tejasnat/LAM-FiniteElementGang/LRC_26_0388_Finite_Element_Gang_Stage_2.pdf

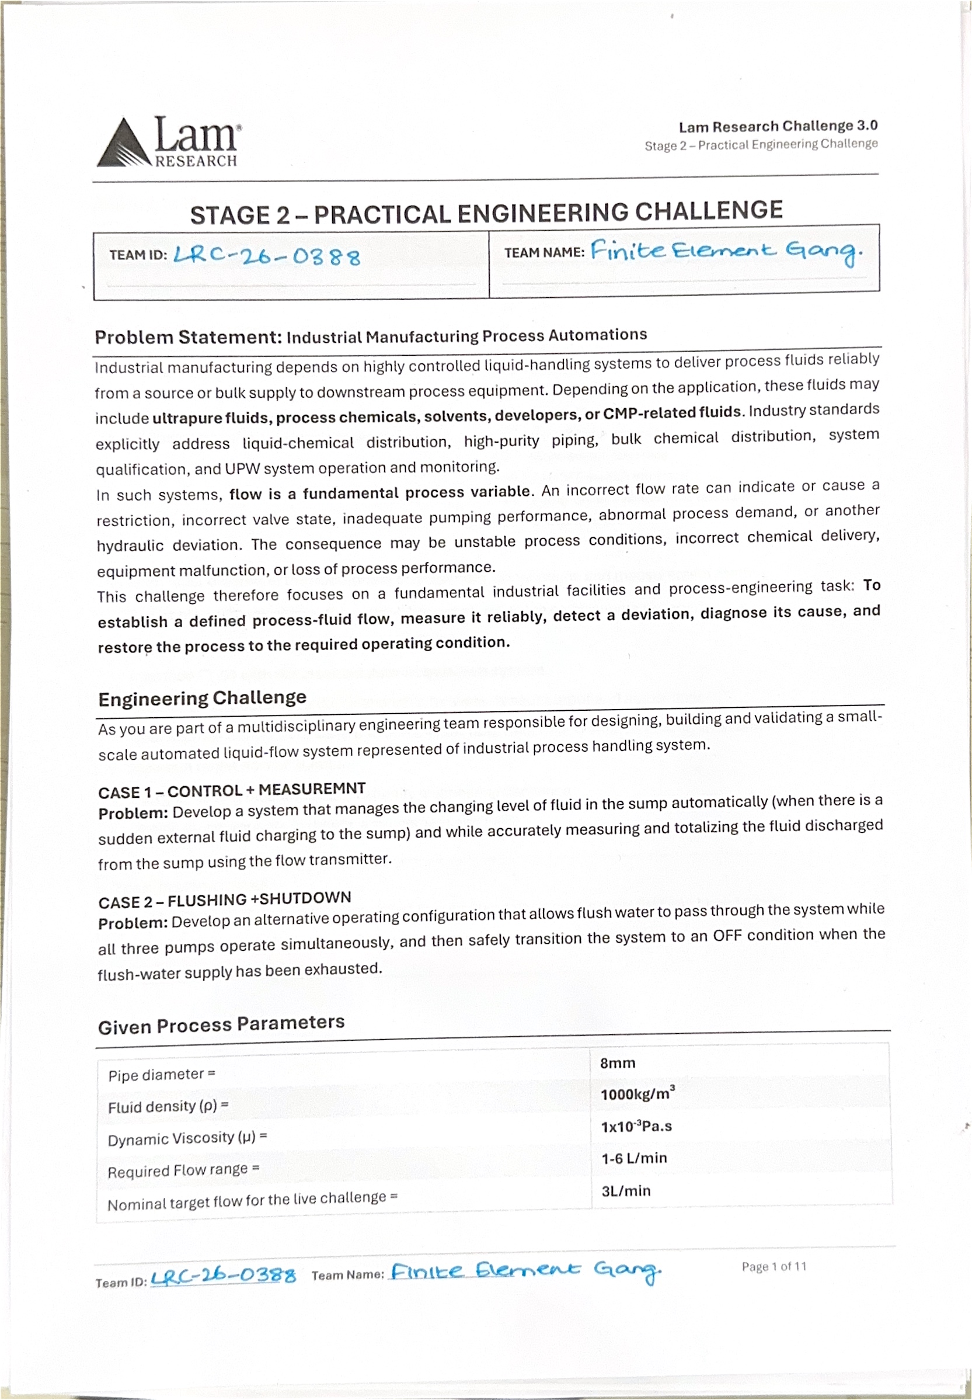
[picture p1: page 1]
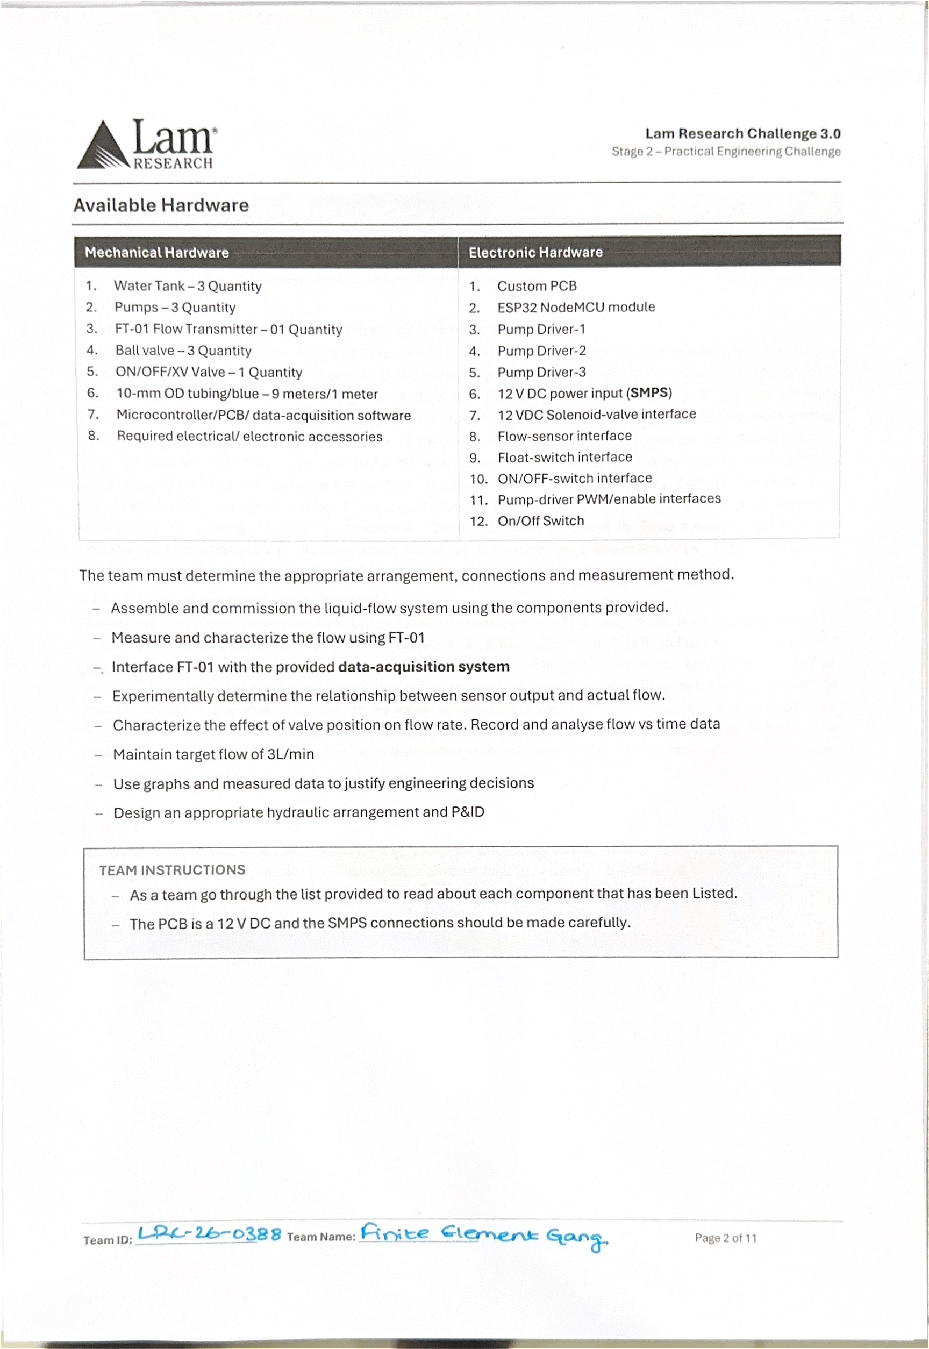
[picture p2: page 2]
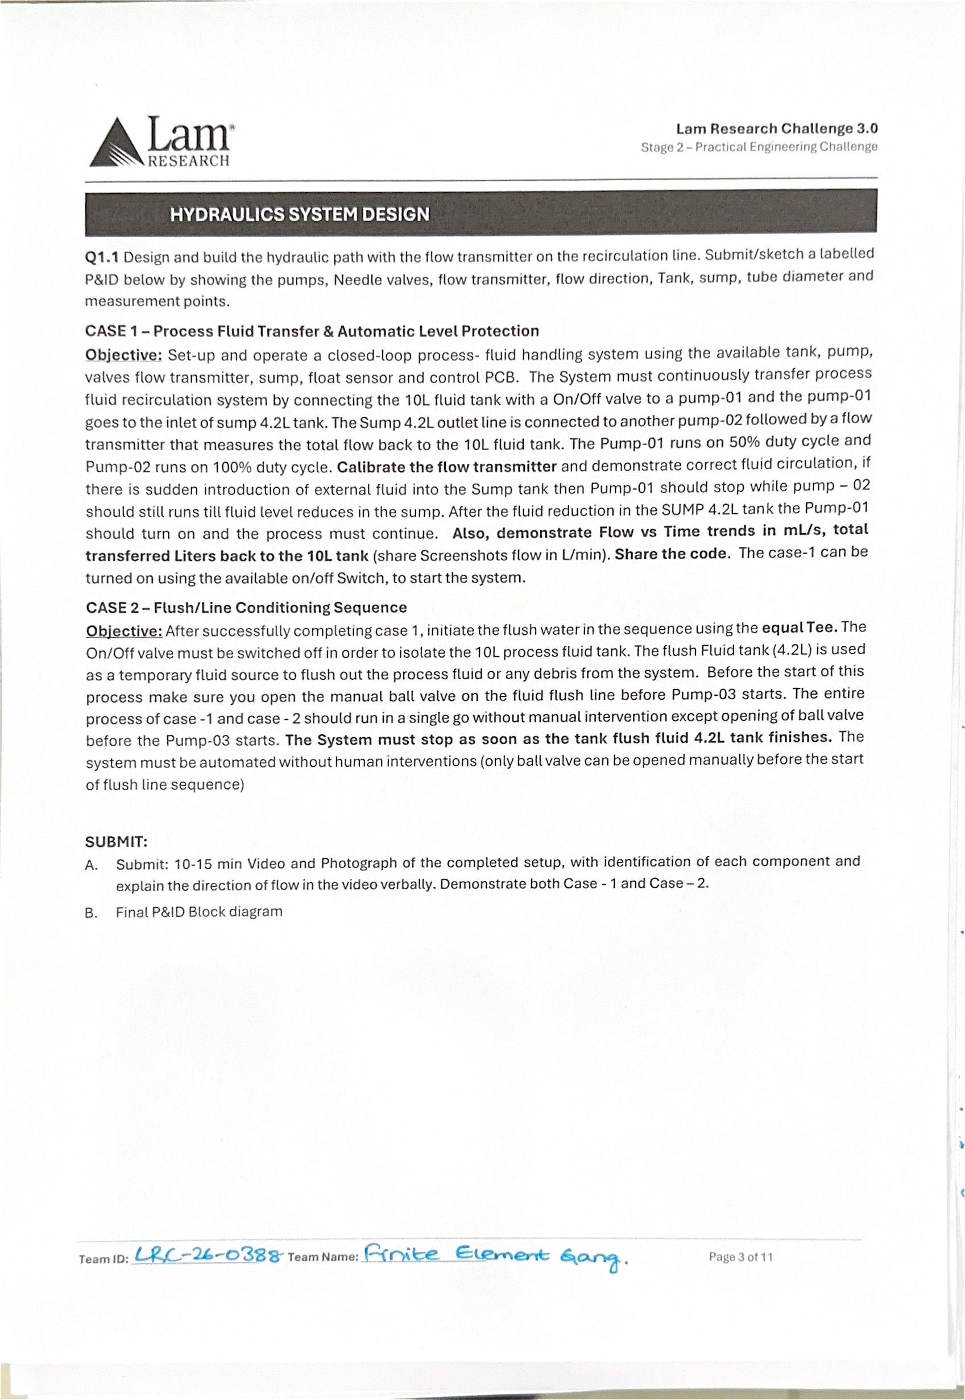
[picture p3: page 3]
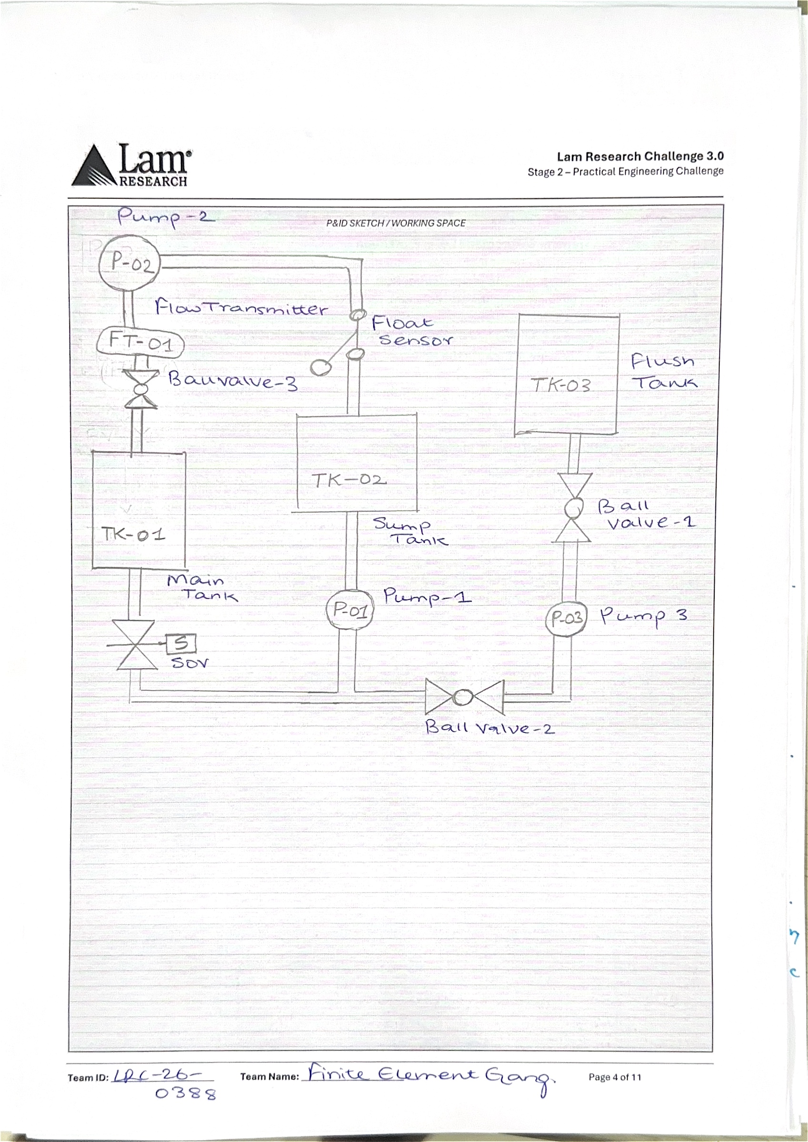
[picture p4: page 4]
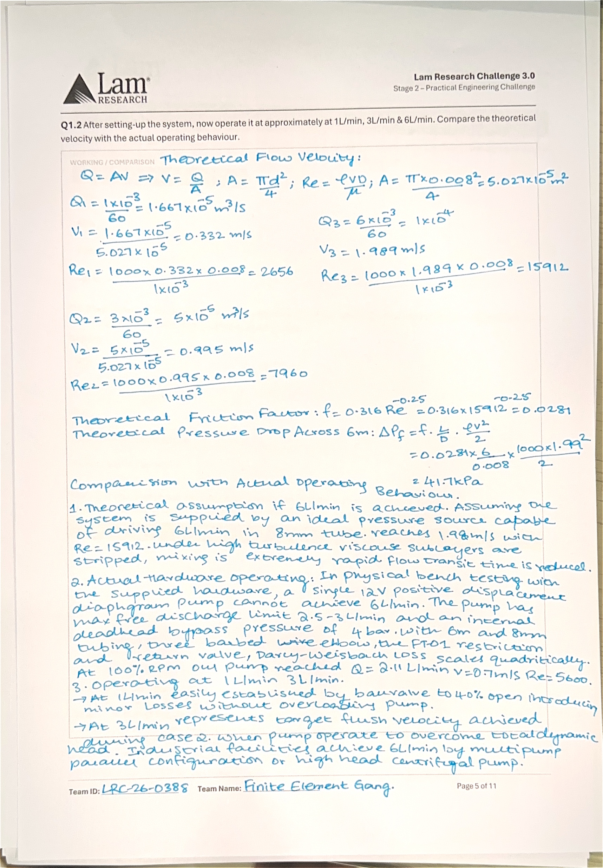
[picture p5: page 5]
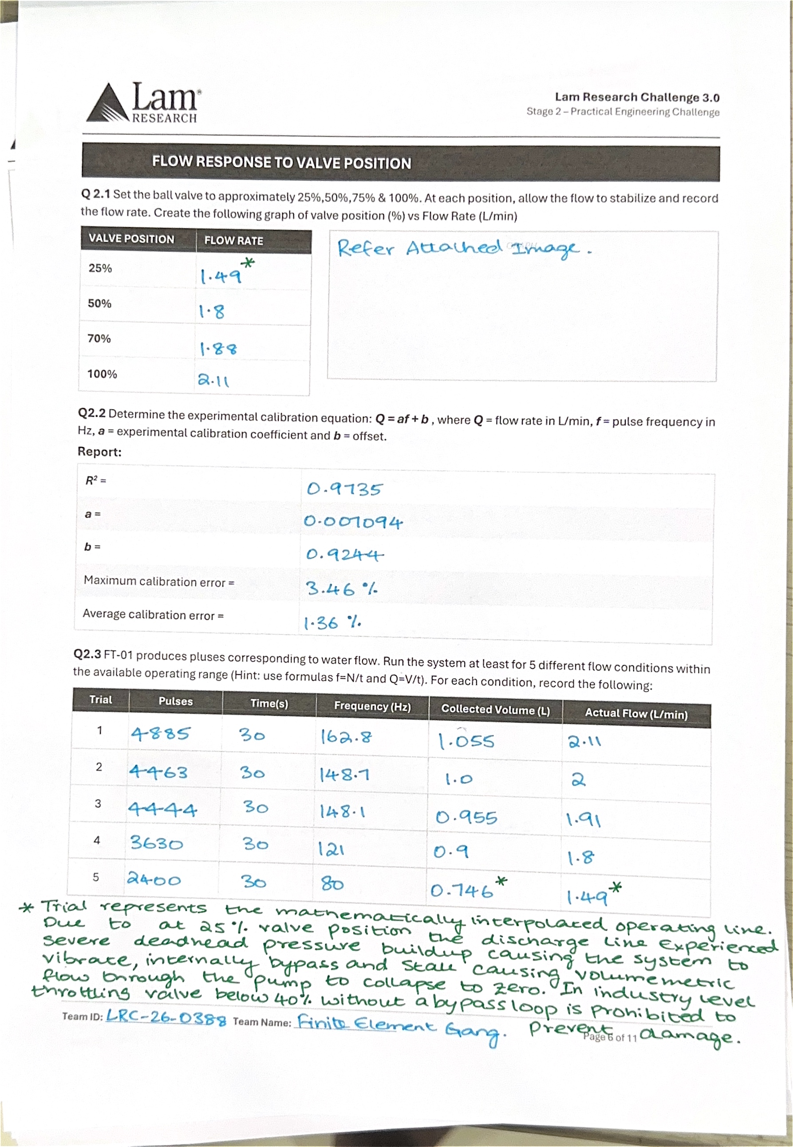
[picture p6: page 6]
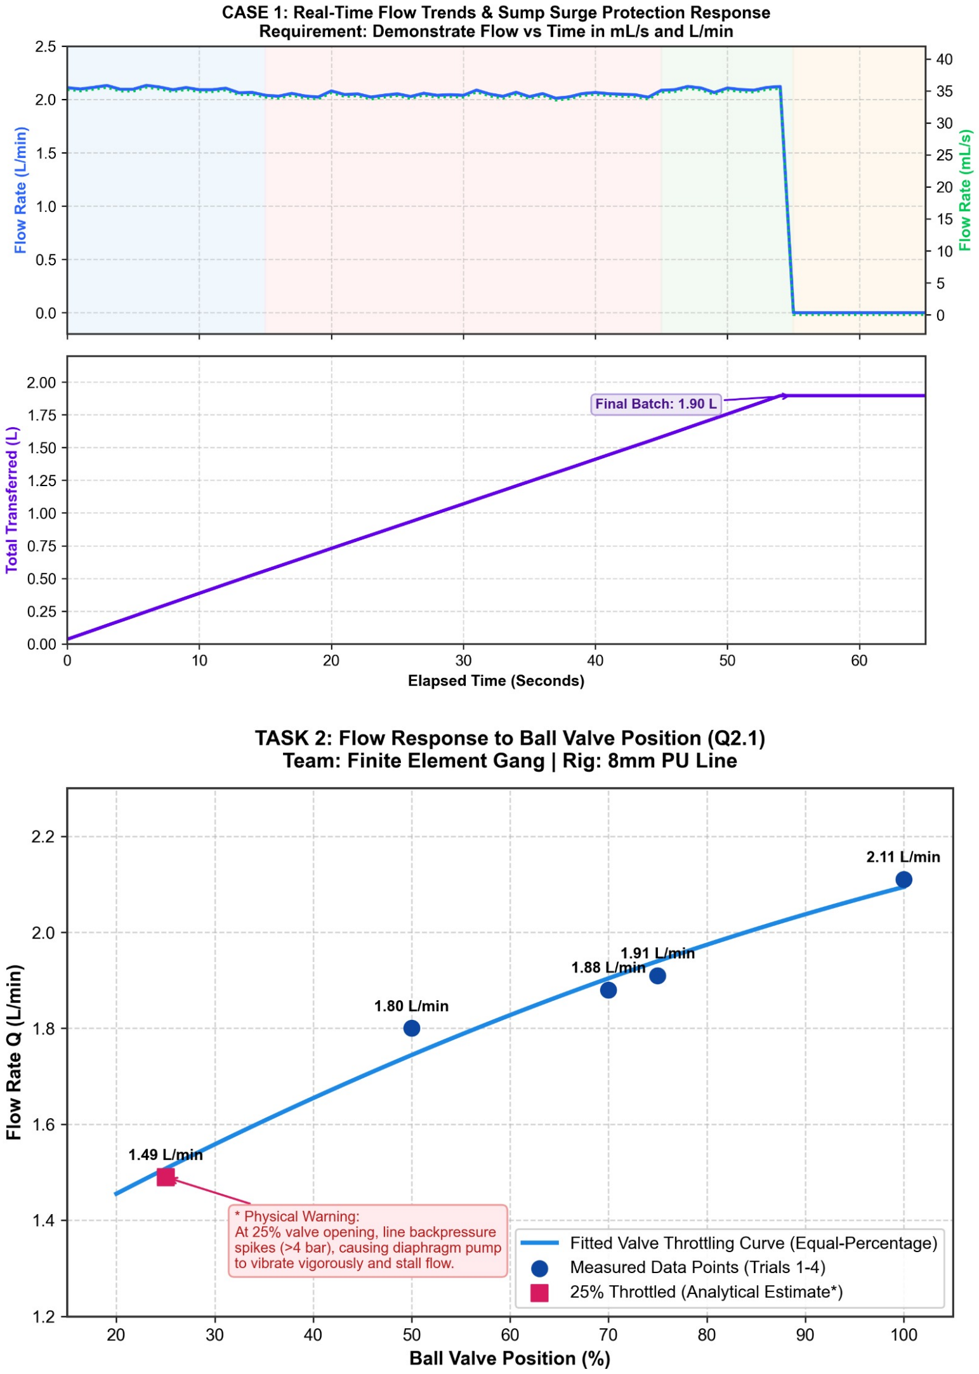
[picture p7: page 7]
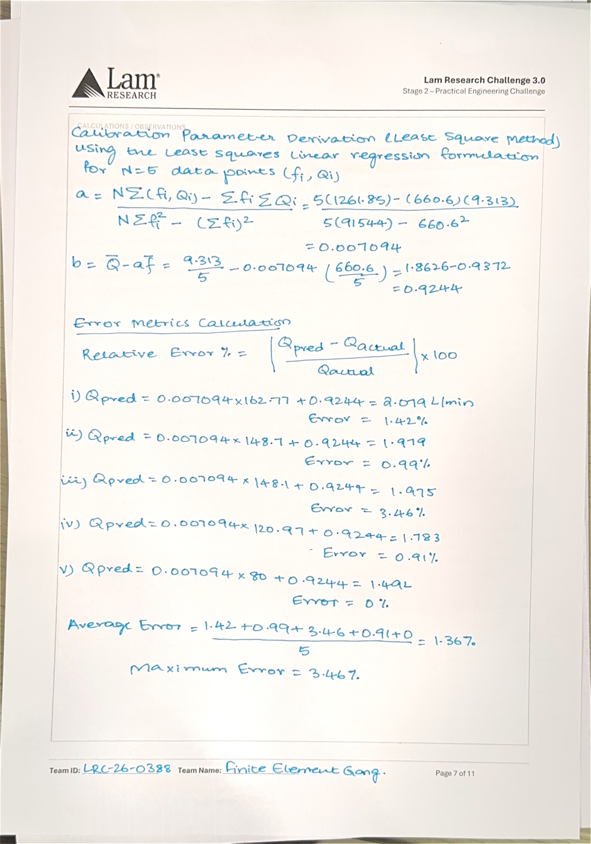
[picture p8: page 8]

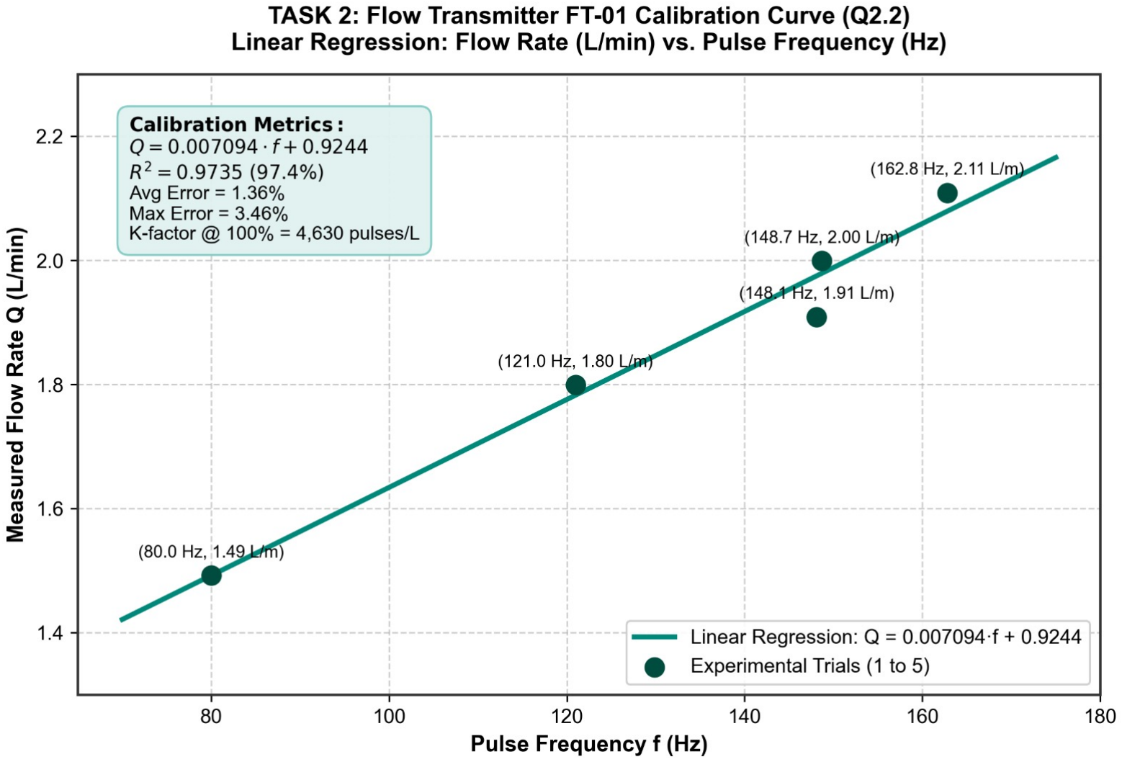
[picture p9: figure]
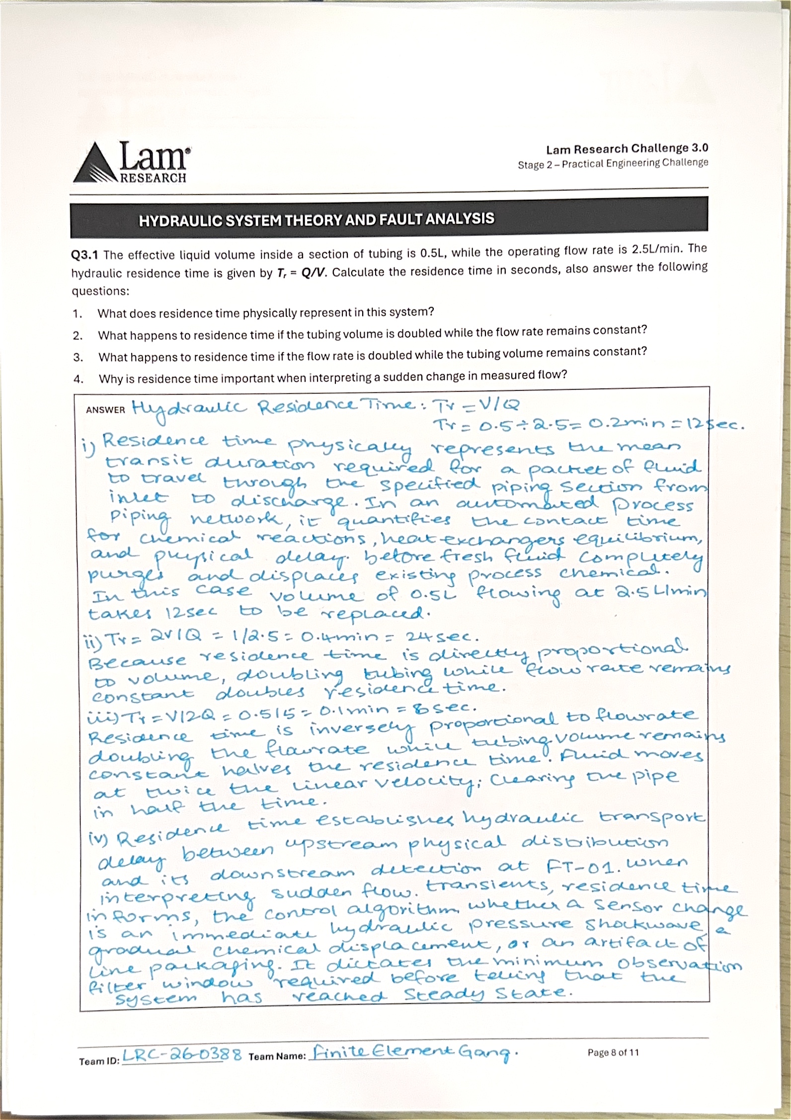
[picture p10: page 10]
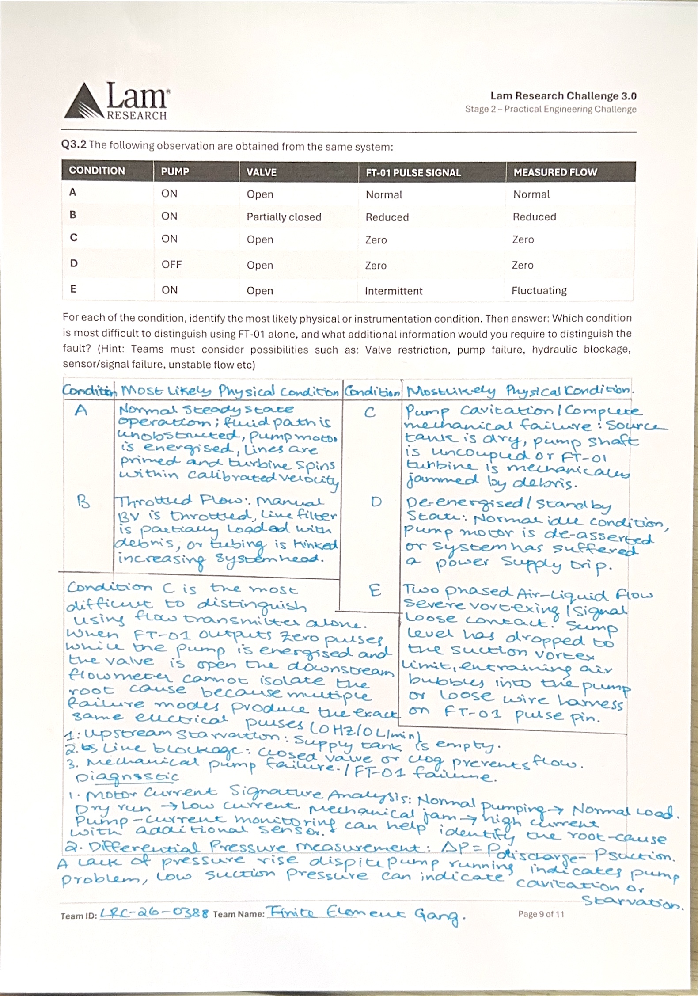
[picture p11: page 11]

/*
*
========================================================================= ===
* Lam Research Challenge 3.0 - Stage 2: Master Dual-Case Automation
* Team: Finite Element Gang
*
========================================================================= ===
* EXECUTION SEQUENCE:
* 1. Case 1 starts with physical Push Button (or 's'). Solenoid OPENS, P1=50%, P2=100%, P3=OFF.
* | 2. Sump Surge Test:
* | - Water tilts float UP (GPIO 35 = LOW).
* | - Pump-01 instantly trips to OFF (0%) and is LOCKED OFF for 30
SECONDS.
* | - Pump-02 drains the sump alone at 100% PWM for the full 30
seconds.
* | 3. Case 1 Resumption (10 Seconds):
* | - After 30s drain, Pump-01 restarts at 50% PWM, Pump-02 stays
at 100%
* | for 10 seconds to prove stable recirculation recovery on
camera.
* | 4. 15-Second Transition Countdown:
* | - Solenoid CLOSES immediately (10L tank isolated). Pumps pause.
* | - Live countdown in Serial Monitor: Operator opens manual valve
BV-03.
* | 5. Case 2 Flush:
* | - All 3 pumps fire at 100% simultaneously.
* | 6. Flush Tank Cutoff (Industrial Batch Totalizer):
* | - Totalizes flushed volume using FT-01 up to 2.50 Liters.
* | - When 2.50L is reached (or early dry-out < 60 Hz), all 3 pumps
* | safely shut down to OFF (0%). Zero human touch.
*
========================================================================= ===
*/

#include <Arduino.h>

// ---------------- HARDWARE PIN ALLOCATIONS ----------------
const int PIN_FLOW_SENSOR | = 14; | // FT-01 Pulse Interrupt
const int PIN_FLOAT_SWITCH = 35; | // LS-01 Sump Float Switch (GPIO 35)
const int PIN_START_BUTTON = 34; | // SW-01 Hardware Push Button (GPIO 34
- ON/OFF_SWITCH header)
const int PIN_SOLENOID | = 27; | // OV-01 Solenoid via D4184 MOSFET

// Motor Driver U2 (Pump-01: Process Feed)
const int PIN_P1_LPWM = 32;
const int PIN_P1_LEN | = 13;
const int PIN_P1_REN | = 26;

// Motor Driver U3 (Pump-02: Recirculation Return) const int PIN_P2_LPWM = 18;
const int PIN_P2_LEN | = 16; | // GPIO 16 (L_EN2)
const int PIN_P2_REN | = 17; | // GPIO 17 (R_EN2)

// Motor Driver U4 (Pump-03: Flush Supply)

const int PIN_P3_LPWM = 23;
const int PIN_P3_LEN | = 21;
const int PIN_P3_REN | = 22;

// ---------------- PWM SETTINGS (ESP32 Core 3.0+) ----------------const int PWM_FREQ = 5000;
const int PWM_RES | = 8; // 8-bit: 0 to 255
const int DUTY_50_PCT | = 128; // 50% PWM Duty Cycle
const int DUTY_100_PCT = 255; // 100% PWM Duty Cycle

// ---------------- FLOW CALIBRATION CONSTANTS (Task 2: Q = a*f + b) ----------------
// Values derived from 5-point experimental recalibration (R^2 = 0.9735, Avg Error = 1.36%):
float cal_a = 0.007094; // Experimental slope
float cal_b = 0.924388; // Experimental offset
const float PULSES_PER_LITER = 4630.0; // Measured pulses per liter at 100% flow

// ---------------- USER CONFIGURABLE THRESHOLDS ----------------
const unsigned long SURGE_STARTUP_IMMUNITY_MS = 3000; // 3s grace on startup before surge can trip
const unsigned long FLOAT_DEBOUNCE_MS | = 500; | // Float must stay
LOW continuously for 500ms
const unsigned long SURGE_DRAIN_TIME_MS | = 30000; // Fixed 30
seconds drain with Pump-01 locked OFF
const unsigned long RESUME_RUN_TIME_MS | = 10000; // 10 seconds
normal Case 1 recovery before Case 2
const unsigned long TRANSITION_TIME_MS | = 15000; // 15 seconds to
open BV-03

// Case 2 Flush Batch Totalizer & Safety Cutoff:
const float | FLUSH_BATCH_TARGET_L | = 2.50; | // Batch totalizer
target: exactly 2.50 Liters
const unsigned long FLUSH_INITIAL_GRACE_MS | = 6000; | // 6s window to
allow lines to fill & prime
const float | FLUSH_ESTABLISHED_FREQ_HZ = 100.0; // Flow considered
established when > 100 Hz (rig runs ~128 Hz)
const float | FLUSH_DRY_CUTOFF_FREQ_HZ | = 60.0; | // Flow collapsing
below 60 Hz means loss of liquid
const int | FLUSH_CUTOFF_CONSECUTIVE_SEC = 2; | // for 2
consecutive seconds

// ---------------- STATE MACHINE STATES ----------------enum SystemState {
STATE_STANDBY,
STATE_CASE1_RECIRC,
STATE_CASE1_SURGE_DRAINING, STATE_CASE1_RESUMED,
STATE_TRANSITION,
STATE_CASE2_FLUSHING,
STATE_SYSTEM_SHUTDOWN
};

SystemState currentState = STATE_STANDBY;

// ---------------- RUNTIME VARIABLES ----------------volatile unsigned long pulseCount = 0; unsigned long prevPulses = 0; unsigned long lastTelemetryTime = 0;

unsigned long stateStartTime = 0; unsigned long surgeDrainStartTime = 0; unsigned long resumeStartTime = 0; unsigned long flushStartPulseCount = 0; unsigned long floatLowStartTime = 0; bool flushFlowEstablished = false; int lastCountdownSec = -1;
int flushDropConsecutiveSeconds = 0;

float totalTransferredLiters = 0.0; // Case 1 calibrated integrated volume (L)
float flushedVolume = 0.0; | // Case 2 calibrated integrated flush
volume (L)

// Flow Sensor Interrupt
void IRAM_ATTR flowISR() { pulseCount++;
}

void setSolenoid(bool open) { digitalWrite(PIN_SOLENOID, open ? HIGH : LOW); }

void setPumpSpeeds(int p1, int p2, int p3) { ledcWrite(PIN_P1_LPWM, p1); ledcWrite(PIN_P2_LPWM, p2); ledcWrite(PIN_P3_LPWM, p3);
}

void emergencyStop() {
currentState = STATE_SYSTEM_SHUTDOWN;
setPumpSpeeds(0, 0, 0);
setSolenoid(false);
Serial.println("\n[EMERGENCY STOP] >>> ALL ACTUATORS KILLED. SYSTEM SAFE. <<<");
Serial.println("[EMERGENCY STOP] Press Push Button or type 's' to restart in STANDBY.\n");
}

void startCase1(unsigned long now) { currentState = STATE_CASE1_RECIRC; stateStartTime = now;
floatLowStartTime = 0;
totalTransferredLiters = 0.0;
setSolenoid(true);
setPumpSpeeds(DUTY_50_PCT, DUTY_100_PCT, 0); Serial.println("\n[PHASE 1] CASE 1 STARTED: NORMAL RECIRCULATION LOOP");
Serial.println(" | - OV-01 Solenoid: OPEN");
Serial.println(" | - Pump-01: 50% PWM | Pump-02: 100% PWM | Pump-03:
OFF");
Serial.println(" - Sump surge protection armed (3s startup immunity active)...\n");
}

void setup() {
Serial.begin(115200);
delay(1000);

pinMode(PIN_SOLENOID, OUTPUT); digitalWrite(PIN_SOLENOID, LOW);

pinMode(PIN_FLOAT_SWITCH, INPUT); pinMode(PIN_START_BUTTON, INPUT);

pinMode(PIN_FLOW_SENSOR, INPUT_PULLUP); attachInterrupt(digitalPinToInterrupt(PIN_FLOW_SENSOR), flowISR, FALLING);

// Pump 1
pinMode(PIN_P1_LEN, OUTPUT); digitalWrite(PIN_P1_LEN, HIGH); pinMode(PIN_P1_REN, OUTPUT); digitalWrite(PIN_P1_REN, HIGH); ledcAttach(PIN_P1_LPWM, PWM_FREQ, PWM_RES); ledcWrite(PIN_P1_LPWM, 0);

// Pump 2
pinMode(PIN_P2_LEN, OUTPUT); digitalWrite(PIN_P2_LEN, HIGH); pinMode(PIN_P2_REN, OUTPUT); digitalWrite(PIN_P2_REN, HIGH); ledcAttach(PIN_P2_LPWM, PWM_FREQ, PWM_RES); ledcWrite(PIN_P2_LPWM, 0);

// Pump 3
pinMode(PIN_P3_LEN, OUTPUT); digitalWrite(PIN_P3_LEN, HIGH); pinMode(PIN_P3_REN, OUTPUT); digitalWrite(PIN_P3_REN, HIGH); ledcAttach(PIN_P3_LPWM, PWM_FREQ, PWM_RES); ledcWrite(PIN_P3_LPWM, 0);

Serial.println("\n======================================================= ");
Serial.println(" LAM Challenge Stage 2 - Master Dual-Case Automation ");
Serial.println(" Team: Finite Element Gang
");

Serial.println("=======================================================") ;
Serial.println("Rig initialized in STANDBY.");
int initFS = digitalRead(PIN_FLOAT_SWITCH);
Serial.printf(" -> Float Switch Pre-Check (GPIO 35): %s\n", (initFS == LOW) ? "CLOSED / UP! (Warning: Sump water is already high!)" : "OPEN / DOWN (OK - Ready for surge)");
int initBtn = digitalRead(PIN_START_BUTTON);
Serial.printf(" | -> Push Button Pre-Check (GPIO 34): | %s\n",
(initBtn == LOW) ? "DETECTED LOW (Pressed / Closed)" : "HIGH (Normal / Open - Ready to press)");
Serial.println(" -> Press PHYSICAL PUSH BUTTON (or type 's') to START CASE 1");
Serial.println(" -> Type 'x' at any time for EMERGENCY STOP");

Serial.println("=======================================================\n ");

}

void loop() {
unsigned long now = millis();

// 1. Process Hardware Push Button (GPIO 34 with 40ms digital debounce) static unsigned long btnPressStartTime = 0;
static bool btnHandled = false;

int btnVal = digitalRead(PIN_START_BUTTON); if (btnVal == LOW) {
if (btnPressStartTime == 0) {
btnPressStartTime = now;
} else if ((now - btnPressStartTime >= 40) && !btnHandled) { btnHandled = true; // Mark handled so holding button doesn't re-trigger
if (currentState == STATE_STANDBY || currentState == STATE_SYSTEM_SHUTDOWN) {
Serial.println("\n>>> [HARDWARE TRIGGER] START PUSH BUTTON PRESSED! <<<");
startCase1(now);
}
}
} else {
btnPressStartTime = 0;
btnHandled = false; // Re-arm once released
}

// 2. Process Serial Commands (Retained as fallback) if (Serial.available() > 0) {
String cmd = Serial.readStringUntil('\n');
cmd.trim();
if (cmd.equalsIgnoreCase("s") || cmd.equalsIgnoreCase("start")) { if (currentState == STATE_STANDBY || currentState == STATE_SYSTEM_SHUTDOWN) {
Serial.println("\n>>> [SERIAL TRIGGER] 's' Command Received! <<<");
startCase1(now);
}
} else if (cmd.equalsIgnoreCase("next") || cmd.equalsIgnoreCase("f")) {
if (currentState == STATE_CASE1_RECIRC || currentState == STATE_CASE1_SURGE_DRAINING || currentState == STATE_CASE1_RESUMED) { currentState = STATE_TRANSITION;
stateStartTime = now;
lastCountdownSec = -1;
setSolenoid(false);
setPumpSpeeds(0, 0, 0);
}
} else if (cmd.equalsIgnoreCase("x") || cmd.equalsIgnoreCase("stop")) {
emergencyStop();
}
}

// 2. Finite State Machine Logic switch (currentState) {
case STATE_STANDBY:

break;

case STATE_CASE1_RECIRC: {
// 3-second startup immunity to prevent false trips during motor spin-up / EMI
if (now - stateStartTime >= SURGE_STARTUP_IMMUNITY_MS) {
bool rawFloat = (digitalRead(PIN_FLOAT_SWITCH) == LOW);
if (rawFloat) {
if (floatLowStartTime == 0) {
floatLowStartTime = now;
} else if (now - floatLowStartTime >= FLOAT_DEBOUNCE_MS) { // Confirmed surge! (Sustained LOW for > 500ms) currentState = STATE_CASE1_SURGE_DRAINING; surgeDrainStartTime = now;
floatLowStartTime = 0;
setPumpSpeeds(0, DUTY_100_PCT, 0); // P1 TRIPPED TO OFF (0%), P2 at 100%
Serial.println("\n[!] >>> SURGE DETECTED! FLOAT SWITCH SUSTAINED TRIGGER <<< [!]"); Serial.println("[!] Pump-01: TRIPPED TO OFF (0%) - LOCKED OFF FOR 30 SECONDS!");
Serial.println("[!] Pump-02: DRAINING SUMP AT 100%...\n"); }
} else {
floatLowStartTime = 0; // Reset debounce timer if it was just an EMI glitch
}
}
break;
}

case STATE_CASE1_SURGE_DRAINING: {
// Pump-01 remains strictly OFF (0%) for the full 20 seconds regardless of float state
if (now - surgeDrainStartTime >= SURGE_DRAIN_TIME_MS) { currentState = STATE_CASE1_RESUMED;
resumeStartTime = now;
setSolenoid(true);
setPumpSpeeds(DUTY_50_PCT, DUTY_100_PCT, 0); // P1 restarted at 50%, P2 at 100%

Serial.println("\n======================================================= ");
Serial.println(" [CASE 1: RESUMED] NORMAL RECIRCULATION RESTORED ");

Serial.println("=======================================================") ;
Serial.println(" - Sump fully evacuated! Pump-01 restarted at 50% PWM.");
Serial.println(" - Running steady-state for 10s before Case 2 transition...");

Serial.println("=======================================================\n ");
}
break;
}

case STATE_CASE1_RESUMED: {
// After 10 seconds of normal recirculation, advance to Transition if (now - resumeStartTime >= RESUME_RUN_TIME_MS) {
currentState = STATE_TRANSITION;
stateStartTime = now;
lastCountdownSec = -1;
setSolenoid(false); | // ISOLATE 10L TANK
setPumpSpeeds(0, 0, 0); // Pause

Serial.println("\n======================================================= ");
Serial.println(" [PHASE 2] CASE 1 COMPLETE -> TRANSITIONING TO CASE 2 ");

Serial.println("=======================================================") ;
Serial.println(" - Case 1 recirculation run verified successfully!");
Serial.println(" - OV-01 Solenoid: CLOSED (10L Tank Isolated!)");
Serial.println(" ==> OPERATOR: OPEN MANUAL BALL VALVE BV-03 NOW! <==");

Serial.println("=======================================================\n ");
}
break;
}

case STATE_TRANSITION: {
unsigned long elapsed = now - stateStartTime;
int remainingSec = (TRANSITION_TIME_MS - elapsed) / 1000;

if (remainingSec != lastCountdownSec && remainingSec >= 0) { Serial.printf("[COUNTDOWN] >>> OPEN BV-03! Flushing starts in %2d seconds <<<\n", remainingSec);
lastCountdownSec = remainingSec;
}

if (elapsed >= TRANSITION_TIME_MS) { currentState = STATE_CASE2_FLUSHING; stateStartTime = now;
flushStartPulseCount = pulseCount;
flushedVolume = 0.0;
flushDropConsecutiveSeconds = 0;
flushFlowEstablished = false; // Arm dynamic empty-tank detection setSolenoid(false);
setPumpSpeeds(DUTY_100_PCT, DUTY_100_PCT, DUTY_100_PCT); // ALL 3 PUMPS 100%

Serial.println("\n======================================================= ");
Serial.println(" [PHASE 3] CASE 2 STARTED: ALL 3 PUMPS FLUSHING (100%)");

Serial.println("=======================================================") ;

Serial.println(" - OV-01 Solenoid: CLOSED (10L Main Tank protected)");
Serial.println(" | - All 3 Pumps running at 100% PWM");
Serial.printf(" | - Batch Totalizer Target: %.2f Liters (Auto-
shutdown on completion)\n", FLUSH_BATCH_TARGET_L);

Serial.println("=======================================================\n ");
}
break;
}

case STATE_CASE2_FLUSHING: break;

case STATE_SYSTEM_SHUTDOWN: break;
}

// 3. Telemetry Stream & Dynamic Flush Tank Cutoff every 1000 ms if (now - lastTelemetryTime >= 1000) {
noInterrupts();
unsigned long currentPulses = pulseCount;
interrupts();

unsigned long deltaPulses = currentPulses - prevPulses;
float dtSec = (lastTelemetryTime == 0) ? 1.0 : ((float)(now -lastTelemetryTime) / 1000.0);
float freqHz = (dtSec > 0.0) ? ((float)deltaPulses / dtSec) : 0.0;

// Uses Task 2 calibration formula: Q = a*f + b (zeroed when stopped) float estFlowLpm = (freqHz < 5.0) ? 0.0 : ((cal_a * freqHz) + cal_b); float estFlowMls = estFlowLpm * (1000.0 / 60.0);
float volumeDeltaL = (estFlowLpm / 60.0) * dtSec;

if (currentState == STATE_CASE1_RECIRC || currentState == STATE_CASE1_SURGE_DRAINING || currentState == STATE_CASE1_RESUMED) { totalTransferredLiters += volumeDeltaL;
} else if (currentState == STATE_CASE2_FLUSHING) { flushedVolume += volumeDeltaL;
}

if (currentState == STATE_CASE1_RECIRC) {
Serial.printf("[CASE 1: NORMAL] Freq: %5.1f Hz | Flow: %4.2f L/min
(%4.1f mL/s) | Total: %4.2f L\n",
freqHz, estFlowLpm, estFlowMls, totalTransferredLiters
);
} else if (currentState == STATE_CASE1_SURGE_DRAINING) { unsigned long drainRemain = (SURGE_DRAIN_TIME_MS > (now -surgeDrainStartTime)) ?
| ((SURGE_DRAIN_TIME_MS - (now -
surgeDrainStartTime)) / 1000) : 0;
Serial.printf("[CASE 1: SURGE DRAIN] Freq: %5.1f Hz | P1:LOCKED OFF
P2:100%% | Sump draining: %2lus left | Total: %4.2f L\n",
freqHz, drainRemain, totalTransferredLiters
);
} else if (currentState == STATE_CASE1_RESUMED) {

unsigned long resumeRemain = (RESUME_RUN_TIME_MS > (now -resumeStartTime)) ?
((RESUME_RUN_TIME_MS - (now -resumeStartTime)) / 1000) : 0;
Serial.printf("[CASE 1: RESUMED] Freq: %5.1f Hz | P1:50%% P2:100%%
| Flow: %4.2f L/min | Transition in: %2lus | Total: %4.2f L\n",
freqHz, estFlowLpm, resumeRemain, totalTransferredLiters
);
} else if (currentState == STATE_CASE2_FLUSHING) {
unsigned long flushElapsed = (now - stateStartTime) / 1000;
Serial.printf("[CASE 2: FLUSHING | %2lus] 3 PUMPS: 100%% | Freq:
%5.1f Hz | Flow: %4.2f L/min | Flushed: %4.2f L / %.2f L\n",
flushElapsed, freqHz, estFlowLpm, flushedVolume, FLUSH_BATCH_TARGET_L
);

// 1. Check if steady flow is established (e.g. lines primed and flowing > 100 Hz)
if (!flushFlowEstablished) {
if (freqHz >= FLUSH_ESTABLISHED_FREQ_HZ) { flushFlowEstablished = true;
Serial.println(" [*] >>> STEADY FLUSH FLOW ESTABLISHED! Totalizing batch volume... <<<"); }
}

// 2. Dual-Lock Cutoff: Target Batch Volume (2.50L) OR Loss of Suction (< 60 Hz for 2s)
bool volumeReached = (flushedVolume >= FLUSH_BATCH_TARGET_L); bool flowDropped = false;

if (flushFlowEstablished || (now - stateStartTime > FLUSH_INITIAL_GRACE_MS)) {
if (freqHz < FLUSH_DRY_CUTOFF_FREQ_HZ) { flushDropConsecutiveSeconds++;
Serial.printf(" [!] FLUSH TANK DRY-OUT: Freq = %.1f Hz (< %.0f Hz) [%d/%d s]\n",
freqHz, FLUSH_DRY_CUTOFF_FREQ_HZ, flushDropConsecutiveSeconds, FLUSH_CUTOFF_CONSECUTIVE_SEC); if (flushDropConsecutiveSeconds >= FLUSH_CUTOFF_CONSECUTIVE_SEC) {
flowDropped = true;
}
} else {
flushDropConsecutiveSeconds = 0; }
}

if (volumeReached || flowDropped) { currentState = STATE_SYSTEM_SHUTDOWN; setPumpSpeeds(0, 0, 0);
setSolenoid(false);

Serial.println("\n======================================================= ");
Serial.printf(" [FINISHED] %.2fL FLUSH BATCH COMPLETED! \n", FLUSH_BATCH_TARGET_L);

if (volumeReached) {
Serial.printf(" [TRIGGER] Target batch volume (%.2f L) successfully delivered!\n", flushedVolume); } else {
Serial.printf(" [TRIGGER] Early dry-out detected (Flow < %.0f Hz)!\n", FLUSH_DRY_CUTOFF_FREQ_HZ);
}
Serial.printf(" [TELEMETRY] Total Volume Flushed: %.2f Liters\n", flushedVolume);
Serial.println(" | [AUTO-SHUTDOWN] ALL THREE PUMPS SAFELY SHUT
DOWN | ");
Serial.println(" | [STATUS] CHALLENGE RUN COMPLETED SUCCESSFULLY!
");

Serial.println("=======================================================") ;
Serial.println("System safely locked in SHUTDOWN. Zero human touch.\n");
}
} else if (currentState == STATE_STANDBY) { Serial.println("[STANDBY] Ready. Press Push Button (or type 's') to start automated sequence.");
}

prevPulses = currentPulses; lastTelemetryTime = now;
}
}

/*
*
========================================================================= ===
* LAM Challenge 3.0 - Task 2: Automated Flow Sensor Calibration Tool
* Team: Finite Element Gang
*
========================================================================= ===
* Exactly matches Task 2 requirements on Page 6 of the PDF:
* | - Runs Pump-02 for EXACTLY 30.0 SECONDS into your measuring jug.
* | - Automatically stops at 30.0s to prevent spillage.
* | - Reports: Time (t), Total Pulses (N), and Exact Frequency (f =
N/t).
* - You read the volume collected in the jug (V in Liters).
*
========================================================================= ===
* INSTRUCTIONS:
* | 1. Direct the tube exiting Valve BV-02 into your measuring jug.
* | 2. Set BV-02 to the desired position (e.g. 100%, 75%, 50%, 25%).
* | 3. Make sure Sump has enough water (~2.5 to 3.0 Liters).
* | 4. Type 'run' (or 'r') in Serial Monitor and press Enter.
* | 5. Pump-02 runs for exactly 30 seconds and automatically cuts off!
* | 6. Note down N, t, f, and the collected volume V from your jug.
*
========================================================================= ===
*/

#include <Arduino.h>

const int PIN_FLOW_SENSOR = 14;

// Motor Driver U3 (Pump-02) const int PIN_P2_LPWM = 18;
const int PIN_P2_LEN | = 16;
const int PIN_P2_REN | = 17;

const int PWM_FREQ = 5000; const int PWM_RES = 8;
const int DUTY_100_PCT = 255;

const unsigned long TRIAL_DURATION_MS = 30000; // Exactly 30 seconds per trial

volatile unsigned long pulseCount = 0;
bool trialRunning = false;
unsigned long trialStartTime = 0;
int lastRemainingSec = -1;
int trialNumber = 1;

void IRAM_ATTR flowISR() { pulseCount++;
}

void setPump2(int duty) {
ledcWrite(PIN_P2_LPWM, duty);

}

void setup() {
Serial.begin(115200);
delay(1000);

pinMode(PIN_FLOW_SENSOR, INPUT_PULLUP); attachInterrupt(digitalPinToInterrupt(PIN_FLOW_SENSOR), flowISR, FALLING);

pinMode(PIN_P2_LEN, OUTPUT); digitalWrite(PIN_P2_LEN, HIGH); pinMode(PIN_P2_REN, OUTPUT); digitalWrite(PIN_P2_REN, HIGH); ledcAttach(PIN_P2_LPWM, PWM_FREQ, PWM_RES); ledcWrite(PIN_P2_LPWM, 0);

Serial.println("\n======================================================= ");
Serial.println(" LAM Challenge - Task 2 Automated Calibration Tool ");
Serial.println(" Team: Finite Element Gang
");

Serial.println("=======================================================") ;
Serial.println("Point the BV-02 hose into your measuring jug."); Serial.println("Set BV-02 valve position (100%, 75%, 50%, 25%)."); Serial.println("--> Type 'run' and press Enter to start 30s timed trial <--");
Serial.println("--> Type 'x' at any time to abort trial <--");

Serial.println("=======================================================\n ");
}

void loop() {
unsigned long now = millis();

// Read Commands
if (Serial.available() > 0) {
String cmd = Serial.readStringUntil('\n');
cmd.trim();

if (cmd.equalsIgnoreCase("run") || cmd.equalsIgnoreCase("r")) { if (!trialRunning) {
// Start timed trial
pulseCount = 0;
trialRunning = true;
trialStartTime = now;
lastRemainingSec = -1;
setPump2(DUTY_100_PCT);

Serial.printf("\n>>> [TRIAL %d STARTED] Pump-02 running at 100%% for 30.0 seconds! <<<\n", trialNumber);
}
} else if (cmd.equalsIgnoreCase("x") || cmd.equalsIgnoreCase("stop")) {
trialRunning = false;

setPump2(0);
Serial.println("\n[!] TRIAL ABORTED. Pump-02 stopped."); }
}

// During Trial
if (trialRunning) {
unsigned long elapsed = now - trialStartTime;
int remainingSec = (TRIAL_DURATION_MS - elapsed) / 1000;

// Print countdown every 5 seconds or last 5 seconds
if (remainingSec != lastRemainingSec && remainingSec >= 0) {
if (remainingSec % 5 == 0 || remainingSec <= 5) { Serial.printf(" [Counting down] %2d seconds remaining... (Live Pulses: %lu)\n",
remainingSec, pulseCount);
}
lastRemainingSec = remainingSec; }

// Trial Complete!
if (elapsed >= TRIAL_DURATION_MS) { setPump2(0); // Stop pump instantly
trialRunning = false;
float actualTimeSec = (float)elapsed / 1000.0;
float frequencyHz = (float)pulseCount / actualTimeSec;

Serial.println("\n======================================================= ");
Serial.printf(" | >>> TRIAL %d COMPLETE! <<<
\n", trialNumber);

Serial.println("=======================================================") ;
Serial.printf(" | Trial Time (t) | : %.2f seconds\n",
actualTimeSec);
Serial.printf(" | Total Pulses (N) | : %lu pulses\n",
pulseCount);
Serial.printf(" | Average Frequency (f) : %.2f Hz | (f = N / t)\n",
frequencyHz);
Serial.println("-------------------------------------------------------");
Serial.println(">> ACTION: Look at your measuring jug!"); Serial.println(">> Note the collected volume (V) in Liters or mL.");

Serial.println("=======================================================") ;
Serial.println("Empty the jug back into the tank, change valve position,");
Serial.println("and type 'run' for the next trial!\n");

trialNumber++;
}
}
}
