tejasnat/LAM-FiniteElementGang/(commit log)

2026-10-15 Add master ESP32 automation code
2026-10-15 Add FT-01 calibration utility
2026-10-15 Move calibration code to code directory
2026-10-15 Remove old firmware calibration path after rename to code
2026-10-15 Add Stage 2 journey video link
2026-10-16 Add Stage 2 challenge video link
